MissouriMRDT/BrushlessGimbalController_Hardware/README.md

# Template_Hardware
Template repository for KiCAD board hardware
