MissouriMRDT/BrushlessGimbalController_Hardware/Hardware/BrushlessGimbalController_Hardware/BrushlessGimbalController_Hardware.kicad_pcb

## KiCad design Hardware/BrushlessGimbalController_Hardware/BrushlessGimbalController_Hardware.kicad_pcb (2025-01-25)

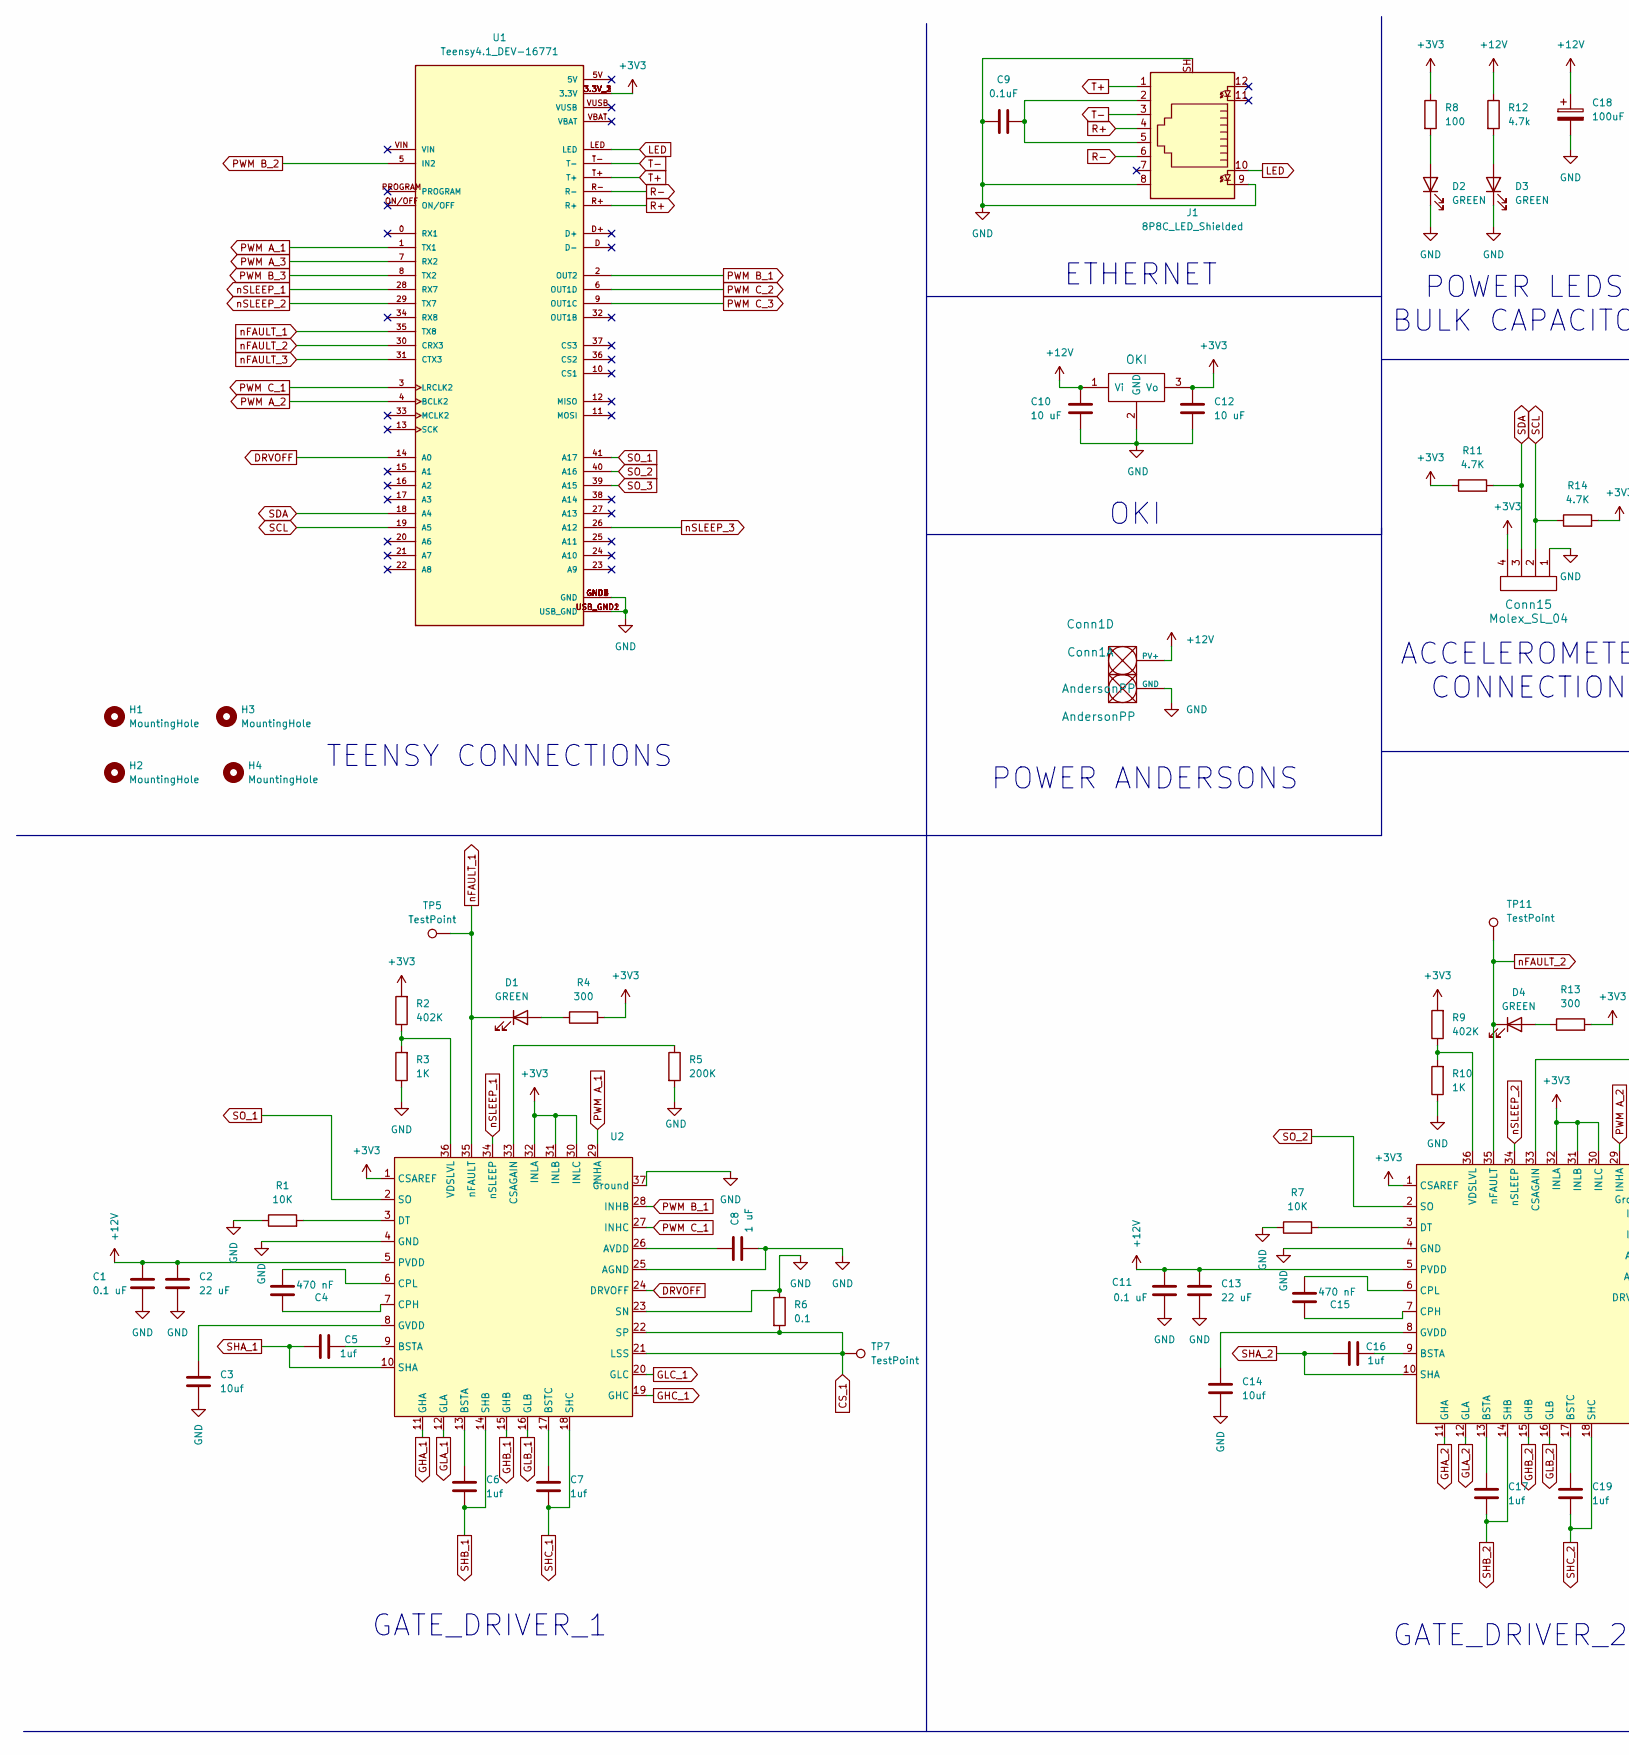
[picture p1: schematic BrushlessGimbalController_Hardware.kicad_sch, part in row 1, column 1]

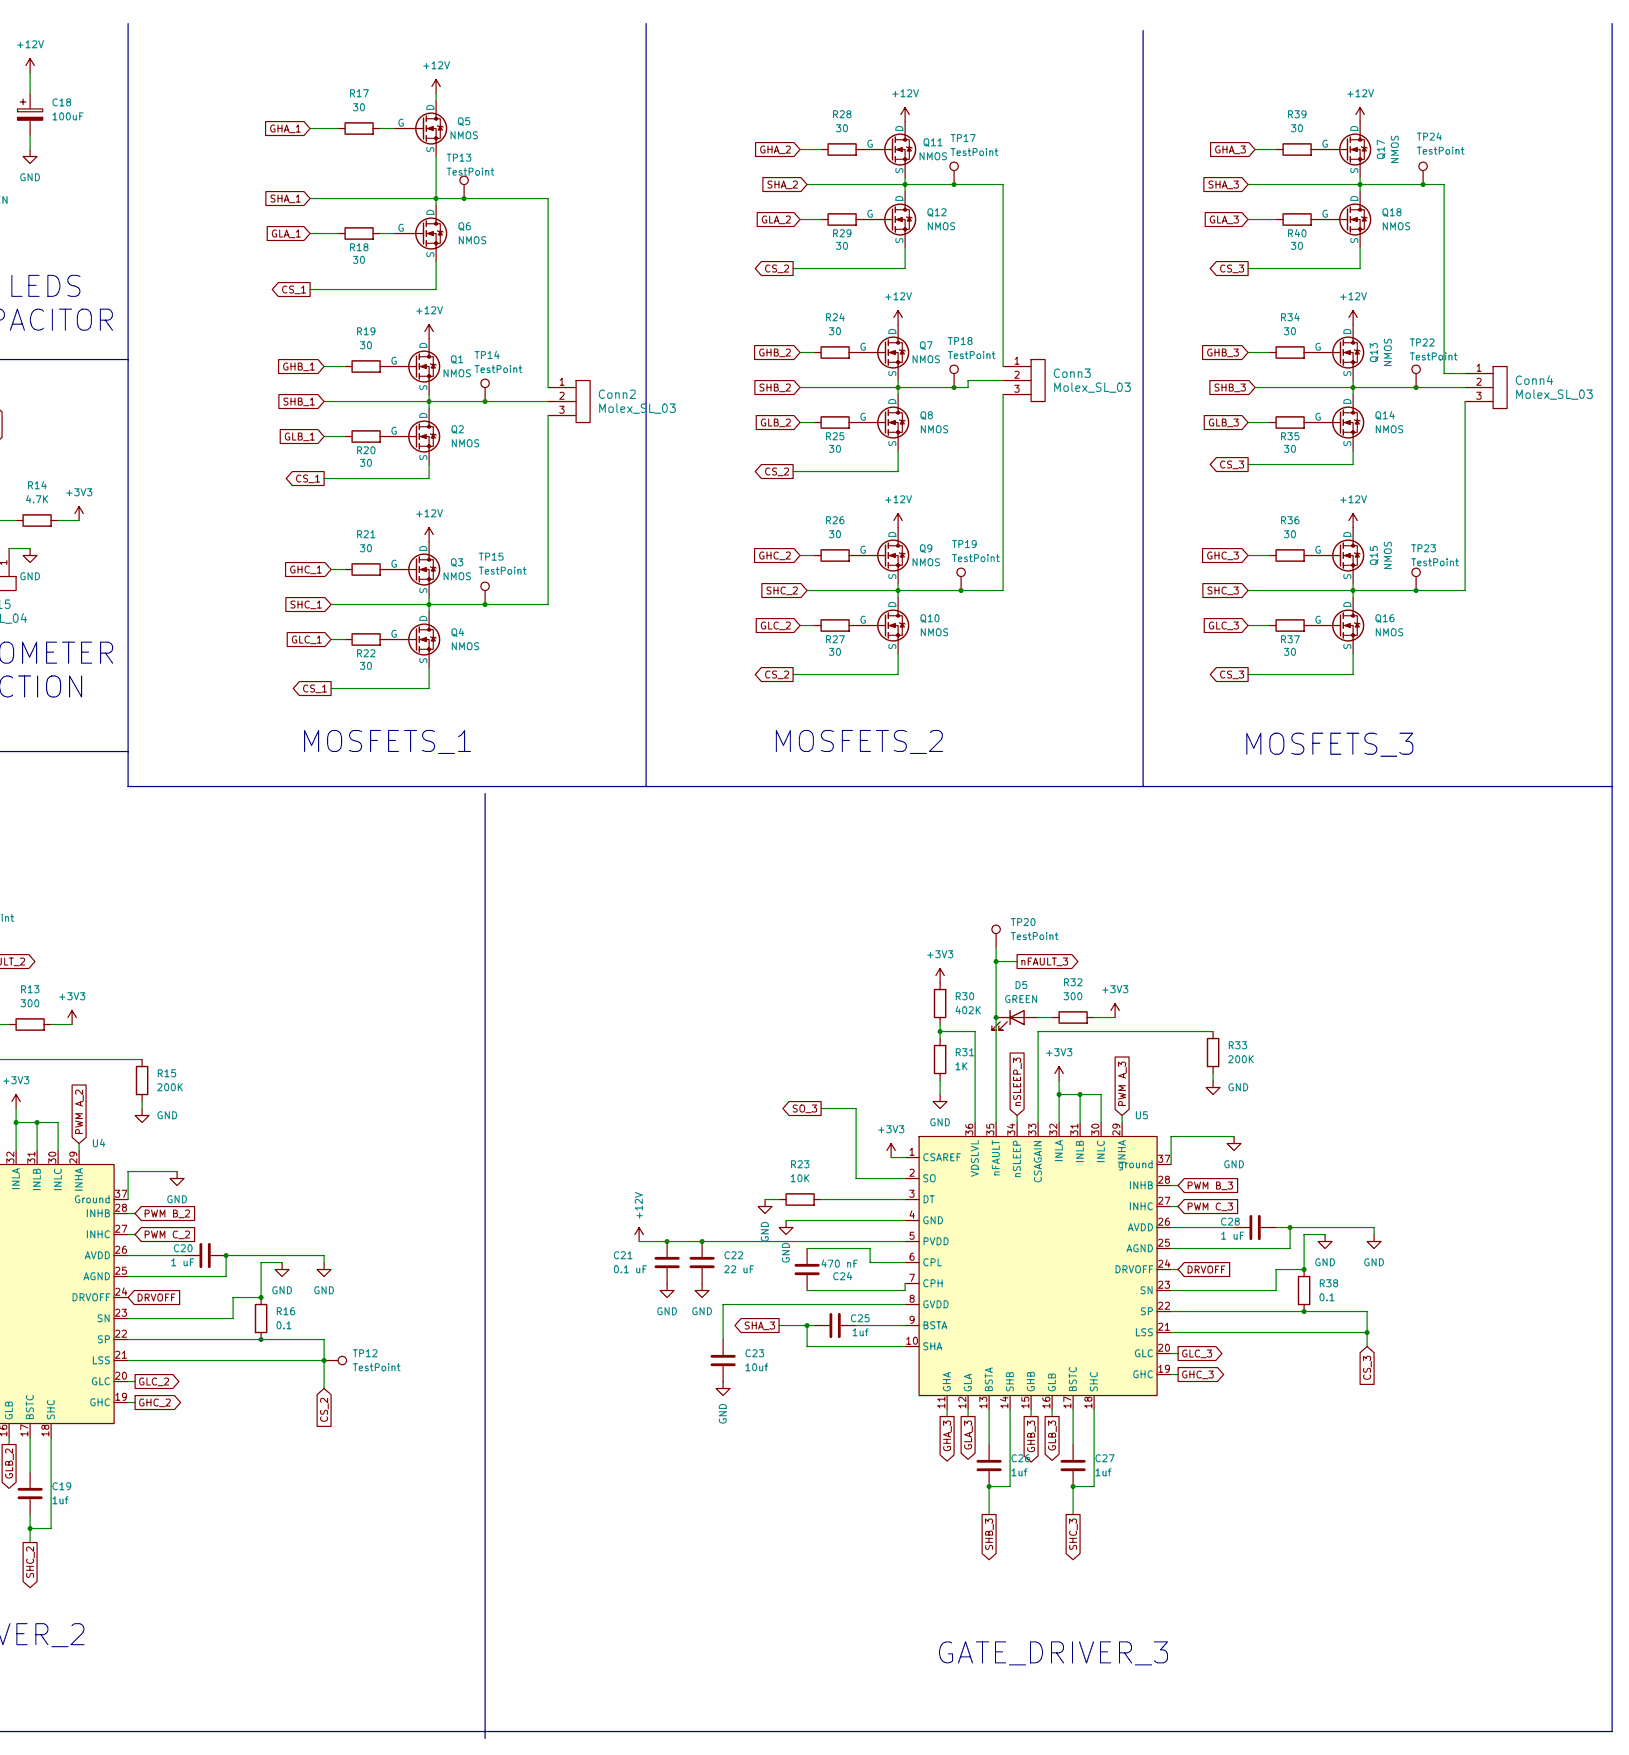
[picture p2: schematic BrushlessGimbalController_Hardware.kicad_sch, part in row 1, column 2]

Parts:
C1, C11, C21: 0.1 uF; C_0603_1608Metric_Pad1.08x0.95mm_HandSolder
C2, C13, C22: 22 uF; CP_Radial_D5.0mm_P2.00mm
C3, C14, C23: 10uf; C_0603_1608Metric_Pad1.08x0.95mm_HandSolder
C4, C15, C24: 470 nF; C_0603_1608Metric_Pad1.08x0.95mm_HandSolder
C5, C6, C7, C16, C17, C19, C25, C26, C27: 1uf; C_0603_1608Metric_Pad1.08x0.95mm_HandSolder
C8, C20, C28: 1 uF; C_0603_1608Metric_Pad1.08x0.95mm_HandSolder
C9: 0.1uF; C_0603_1608Metric_Pad1.08x0.95mm_HandSolder
C10, C12: 10 uF; C_0603_1608Metric_Pad1.08x0.95mm_HandSolder
C18: 100uF; C_Radial_D6.3mm_H5.0mm_P2.50mm
Conn1: AndersonPP; Square_Anderson_2_H_Side_By_Side
Conn2, Conn3, Conn4: Molex_SL_03; Molex_SL_171971-0003_1x03_P2.54mm_Vertical
Conn15: Molex_SL_04; MOLEX_SL_04_Vertical
D1, D2, D3, D4, D5: GREEN; LED_0603_1608Metric_Pad1.05x0.95mm_HandSolder
H1, H2, H3, H4: MountingHole; MountingHole_3mm
J1: 8P8C_LED_Shielded; RJ45_Teensy
Q1, Q2, Q3, Q4, Q5, Q6, Q7, Q8, Q9, Q10, Q11, Q12, Q13, Q14, Q15, Q16, Q17, Q18: NMOS; SOT-23-3
R1, R7, R23: 10K; R_0603_1608Metric_Pad0.98x0.95mm_HandSolder
R2, R9, R30: 402K; R_0603_1608Metric_Pad0.98x0.95mm_HandSolder
R3, R10, R31: 1K; R_0603_1608Metric_Pad0.98x0.95mm_HandSolder
R4, R13, R32: 300; R_0603_1608Metric_Pad0.98x0.95mm_HandSolder
R5, R15, R33: 200K; R_0603_1608Metric_Pad0.98x0.95mm_HandSolder
R6, R16, R38: 0.1; R_2816_7142Metric_Pad3.20x4.45mm_HandSolder
R8: 100; R_0603_1608Metric_Pad0.98x0.95mm_HandSolder
R11, R14: 4.7K; R_0603_1608Metric_Pad0.98x0.95mm_HandSolder
R12: 4.7k; R_0603_1608Metric_Pad0.98x0.95mm_HandSolder
R17, R18, R19, R20, R21, R22, R24, R25, R26, R27, R28, R29, R34, R35, R36, R37, R39, R40: 30; R_0603_1608Metric_Pad0.98x0.95mm_HandSolder
TP5, TP7, TP11, TP12, TP13, TP14, TP15, TP17, TP18, TP19, TP20, TP22, TP23, TP24: TestPoint; TestPoint_Pad_D2.0mm
U1: Teensy4.1_DEV-16771; Teensy_4_1; PARTREV 4.1
U2, U4, U5: REE0036A-IPC_A
U3: OKI; Converter_DCDC_Murata_OKI-78SR_Horizontal

Connections:
+3V3: C12.1, Conn15.4, R2.2, R4.2, R8.1, R9.2, R11.1, R13.2, R14.2, R30.2, R32.2, U1.3.3V_1 (3.3V), U1.3.3V_2 (3.3V), U1.3.3V_3 (3.3V), U2.1 (CSAREF), U2.30 (INLC), U2.31 (INLB), U2.32 (INLA), U3.3 (Vo), U4.1 (CSAREF), U4.30 (INLC), U4.31 (INLB), U4.32 (INLA), U5.1 (CSAREF), U5.30 (INLC), U5.31 (INLB), U5.32 (INLA)
+12V: C1.2, C2.2, C10.1, C11.2, C13.2, C18.1, C21.2, C22.2, Conn1.2 (PV+), Q1.1 (D), Q3.1 (D), Q5.1 (D), Q7.1 (D), Q9.1 (D), Q11.1 (D), Q13.1 (D), Q15.1 (D), Q17.1 (D), R12.1, U2.5 (PVDD), U3.1 (Vi), U4.5 (PVDD), U5.5 (PVDD)
CS_1: Q2.3 (S), Q4.3 (S), Q6.3 (S), R6.2, TP7.1, U2.21 (LSS), U2.22 (SP)
CS_2: Q8.3 (S), Q10.3 (S), Q12.3 (S), R16.2, TP12.1, U4.21 (LSS), U4.22 (SP)
CS_3: Q14.3 (S), Q16.3 (S), Q18.3 (S), R38.2, U5.21 (LSS), U5.22 (SP); also elsewhere on the board
DRVOFF: U1.14 (A0), U2.24 (DRVOFF), U4.24 (DRVOFF), U5.24 (DRVOFF)
GHA_1: R17.1, U2.11 (GHA)
GHA_2: R28.1, U4.11 (GHA)
GHA_3: R39.1, U5.11 (GHA)
GHB_1: R19.1, U2.15 (GHB)
GHB_2: R24.1, U4.15 (GHB)
GHB_3: R34.1, U5.15 (GHB)
GHC_1: R21.1, U2.19 (GHC)
GHC_2: R26.1, U4.19 (GHC)
GHC_3: R36.1, U5.19 (GHC)
GLA_1: R18.1, U2.12 (GLA)
GLA_2: R29.1, U4.12 (GLA)
GLA_3: R40.1, U5.12 (GLA)
GLB_1: R20.1, U2.16 (GLB)
GLB_2: R25.1, U4.16 (GLB)
GLB_3: R35.1, U5.16 (GLB)
GLC_1: R22.1, U2.20 (GLC)
GLC_2: R27.1, U4.20 (GLC)
GLC_3: R37.1, U5.20 (GLC)
GND: C1.1, C2.1, C3.2, C8.1, C9.1, C10.2, C11.1, C12.2, C13.1, C14.2, C18.2, C20.1, C21.1, C22.1, C23.2, C28.1, Conn1.1 (GND), Conn15.1, D2.1 (K), D3.1 (K), J1.8, J1.9, J1.SH, R1.1, R3.1, R5.2, R6.1, R7.1, R10.1, R15.2, R16.1, R23.1, R31.1, R33.2, R38.1, U1.GND1 (GND), U1.GND2 (GND), U1.GND3 (GND), U1.GND4 (GND), U1.GND5 (GND), U1.USB_GND1 (USB_GND), U1.USB_GND2 (USB_GND), U2.4 (GND), U2.23 (SN), U2.25 (AGND), U2.37 (Ground), U3.2 (GND), U4.4 (GND), U4.23 (SN), U4.25 (AGND), U4.37 (Ground), U5.4 (GND), U5.23 (SN), U5.25 (AGND), U5.37 (ground)
LED: J1.10, U1.LED
unnamed: C5.1, U2.9 (BSTA)
unnamed: C6.1, U2.13 (BSTA)
unnamed: C9.2, J1.2, J1.5
unnamed: C16.1, U4.9 (BSTA)
unnamed: C17.1, U4.13 (BSTA)
unnamed: C25.2, U5.9 (BSTA)
unnamed: C26.1, U5.13 (BSTA)
unnamed: D1.2 (A), R4.1
unnamed: D2.2 (A), R8.2
unnamed: D3.2 (A), R12.2
unnamed: D4.2 (A), R13.1
unnamed: D5.2 (A), R32.1
unnamed: Q1.2 (G), R19.2
unnamed: Q2.2 (G), R20.2
unnamed: Q3.2 (G), R21.2
unnamed: Q4.2 (G), R22.2
unnamed: Q5.2 (G), R17.2
unnamed: Q6.2 (G), R18.2
unnamed: Q7.2 (G), R24.2
unnamed: Q8.2 (G), R25.2
unnamed: Q9.2 (G), R26.2
unnamed: Q10.2 (G), R27.2
unnamed: Q11.2 (G), R28.2
unnamed: Q12.2 (G), R29.2
unnamed: Q13.2 (G), R34.2
unnamed: Q14.2 (G), R35.2
unnamed: Q15.2 (G), R36.2
unnamed: Q16.2 (G), R37.2
unnamed: Q17.2 (G), R39.2
unnamed: Q18.2 (G), R40.2
unnamed: C8.2, U2.26 (AVDD)
unnamed: C7.1, U2.17 (BSTC)
unnamed: C4.2, U2.7 (CPH)
unnamed: C4.1, U2.6 (CPL)
unnamed: R5.1, U2.33 (CSAGAIN)
unnamed: R1.2, U2.3 (DT)
unnamed: C3.1, U2.8 (GVDD)
unnamed: R2.1, R3.2, U2.36 (VDSLVL)
unnamed: C20.2, U4.26 (AVDD)
unnamed: C19.1, U4.17 (BSTC)
unnamed: C15.2, U4.7 (CPH)
unnamed: C15.1, U4.6 (CPL)
unnamed: R15.1, U4.33 (CSAGAIN)
unnamed: R7.2, U4.3 (DT)
unnamed: C14.1, U4.8 (GVDD)
unnamed: R9.1, R10.2, U4.36 (VDSLVL)
unnamed: C28.2, U5.26 (AVDD)
unnamed: C27.1, U5.17 (BSTC)
unnamed: C24.2, U5.7 (CPH)
unnamed: C24.1, U5.6 (CPL)
unnamed: R33.1, U5.33 (CSAGAIN)
unnamed: R23.2, U5.3 (DT)
unnamed: C23.1, U5.8 (GVDD)
unnamed: R30.1, R31.2, U5.36 (VDSLVL)
PWM A_1: U1.1 (TX1), U2.29 (INHA)
PWM A_2: U1.4 (BCLK2), U4.29 (INHA)
PWM A_3: U1.7 (RX2), U5.29 (INHA)
PWM B_1: U1.2 (OUT2), U2.28 (INHB)
PWM B_2: U1.5 (IN2), U4.28 (INHB)
PWM B_3: U1.8 (TX2), U5.28 (INHB)
PWM C_1: U1.3 (LRCLK2), U2.27 (INHC)
PWM C_2: U1.6 (OUT1D), U4.27 (INHC)
PWM C_3: U1.9 (OUT1C), U5.27 (INHC)
R+: J1.4, U1.R+
R-: J1.6, U1.R-
SCL: Conn15.2, R14.1, U1.19 (A5)
SDA: Conn15.3, R11.2, U1.18 (A4)
SHA_1: C5.2, Conn2.1, Q5.3 (S), Q6.1 (D), TP13.1, U2.10 (SHA)
SHA_2: C16.2, Conn3.1, Q11.3 (S), Q12.1 (D), TP17.1, U4.10 (SHA)
SHA_3: C25.1, Conn4.1, Q17.3 (S), Q18.1 (D), TP24.1, U5.10 (SHA)
SHB_1: C6.2, Conn2.2, Q1.3 (S), Q2.1 (D), TP14.1, U2.14 (SHB)
SHB_2: C17.2, Conn3.2, Q7.3 (S), Q8.1 (D), TP18.1, U4.14 (SHB)
SHB_3: C26.2, Conn4.2, Q13.3 (S), Q14.1 (D), TP22.1, U5.14 (SHB)
SHC_1: C7.2, Conn2.3, Q3.3 (S), Q4.1 (D), TP15.1, U2.18 (SHC)
SHC_2: C19.2, Conn3.3, Q9.3 (S), Q10.1 (D), TP19.1, U4.18 (SHC)
SHC_3: C27.2, Conn4.3, Q15.3 (S), Q16.1 (D), TP23.1, U5.18 (SHC)
SO_1: U1.41 (A17), U2.2 (SO)
SO_2: U1.40 (A16), U4.2 (SO)
SO_3: U1.39 (A15), U5.2 (SO)
T+: J1.1, U1.T+
T-: J1.3, U1.T-
nFAULT_1: D1.1 (K), TP5.1, U1.35 (TX8), U2.35 (nFAULT)
nFAULT_2: D4.1 (K), TP11.1, U1.30 (CRX3), U4.35 (nFAULT)
nFAULT_3: D5.1 (K), TP20.1, U1.31 (CTX3), U5.35 (nFAULT)
nSLEEP_1: U1.28 (RX7), U2.34 (nSLEEP)
nSLEEP_2: U1.29 (TX7), U4.34 (nSLEEP)
nSLEEP_3: U1.26 (A12), U5.34 (nSLEEP)

Notes on the sheet:
GATE_DRIVER_3
TEENSY CONNECTIONS
MOSFETS_1
POWER ANDERSONS
POWER LEDS BULK CAPACITOR
GATE_DRIVER_1
ACCELEROMETER CONNECTION
MOSFETS_2
MOSFETS_3
ETHERNET
GATE_DRIVER_2
OKI

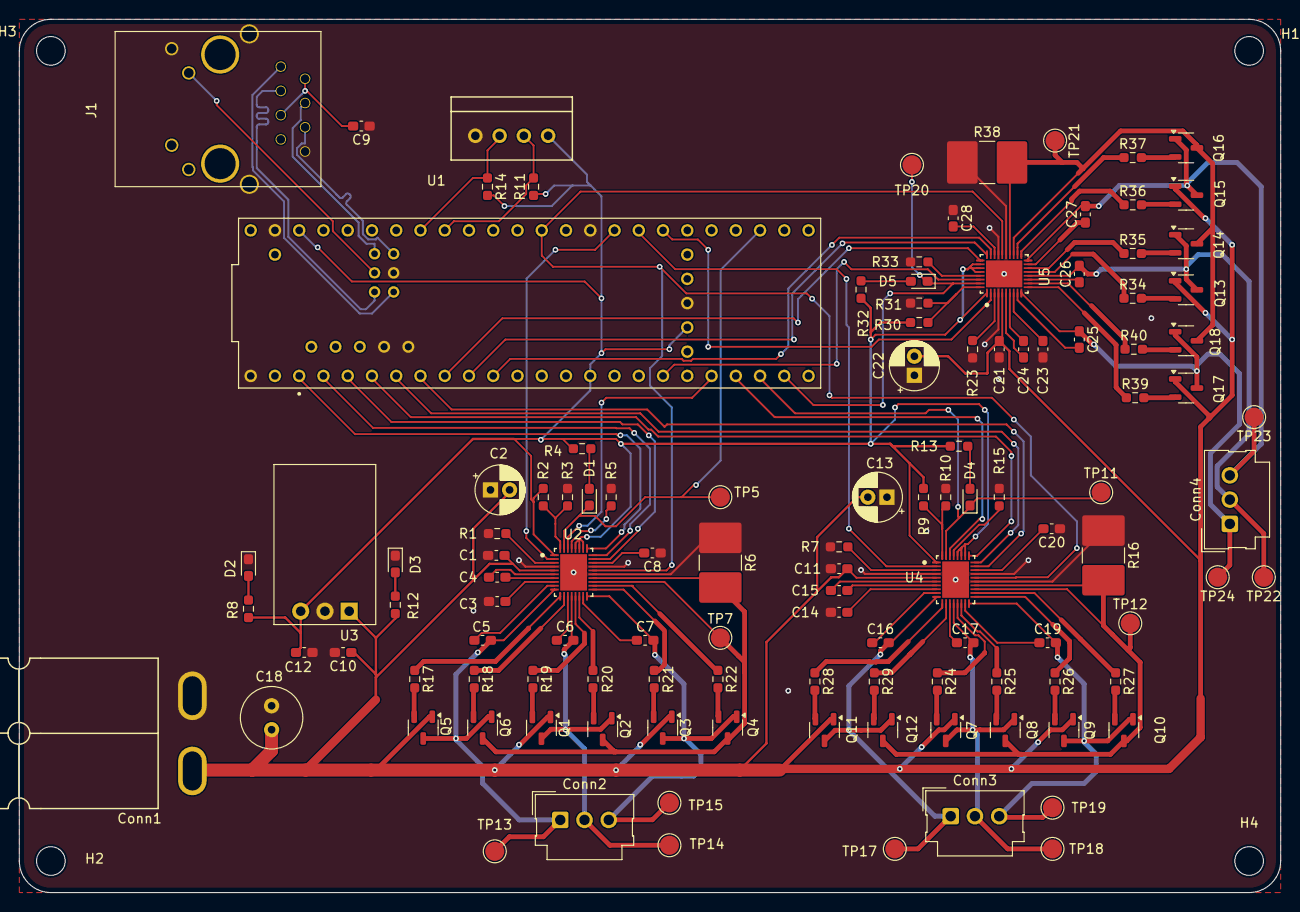
[picture p3: board BrushlessGimbalController_Hardware.kicad_pcb from above]

Board: 2 copper layers, 132.1 x 91.4 mm, 121 parts (0 on the bottom side), 113 nets.

Other parts of the board:
TP21: TestPoint; TestPoint_Pad_D2.0mm

Their connections:
CS_3: TP21.1; also elsewhere on the board
