MissouriMRDT/BrushlessGimbalController_Hardware/(commit log)

2024-11-14 Schematic or something
    real
    [DRV8329.kicad_sch, sus_gimbal_controller.kicad_pcb, sus_gimbal_controller.kicad_sch, untitled.kicad_sch]
2024-11-14 Added datasheet
    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
    [untitled.kicad_sch]
2024-11-14 filepath
    to be fixed
    [untitled.kicad_sch]
2024-11-14 Un-fucking files pt.2
    [BrushlessGimbalController_Hardware.kicad_pcb, BrushlessGimbalController_Hardware.kicad_sch, DRV8329.kicad_sch, sus_gimbal_controller.kicad_sch]
2025-01-17 Layout Ready For Review
    Added all of the traces and ground planes and vias and things
    [BrushlessGimbalController_Hardware.kicad_pcb, BrushlessGimbalController_Hardware.kicad_sch]
2025-01-21 Layout revisions
    Layout revisions implemented from conversation with Drew
    Edge cuts added
    Vias added to ground planes
    Ethernet connector moved to not attach to Teensey
    Hopefully ready for order whenever next board order date is
    [BrushlessGimbalController_Hardware.kicad_pcb, BrushlessGimbalController_Hardware.kicad_sch]
2025-01-23 Garrett Changes
    Fixed some stray disconnected traces
    Added mounting holes to schematic
    Flipped ethernet port placement 180 degrees
    Adjusted skew on Ethernet differential pairs
    Replaced 470nf capacitor with correct 0603 ceramic capacitor (Was 470 uf and electrolytic)
    Removed test points measurable directly from Teensey or Andersons
    [BrushlessGimbalController_Hardware.kicad_pcb, BrushlessGimbalController_Hardware.kicad_sch]
2025-01-25 Final changes before ordering (hopefully)
    Added a pin for the ground pad in the middle of the microcontrollers so it would actually connect to ground
    Also added a via to the ground pad in the middle of the microcontroller because the schematic example had some
    Put vias on some other non-connected ground plane areas
    [BrushlessGimbalController_Hardware.kicad_pcb, BrushlessGimbalController_Hardware.kicad_sch]
2025-01-25 gerber files and BOM
    made a zip folder for Gerber files
    generated BOM
    [BrushlessGimbalController_Hardware-B_Cu.gbr, BrushlessGimbalController_Hardware-B_Mask.gbr, BrushlessGimbalController_Hardware-B_Paste.gbr, BrushlessGimbalController_Hardware-B_Silkscreen.gbr, BrushlessGimbalController_Hardware-Edge_Cuts.gbr, BrushlessGimbalController_Hardware-F_Cu.gbr, BrushlessGimbalController_Hardware-F_Mask.gbr, BrushlessGimbalController_Hardware-F_Paste.gbr]
